eightonegulf/OpenController/Hardware/Main/Main.kicad_pcb

## KiCad design Hardware/Main/Main.kicad_pcb (2024-09-18)

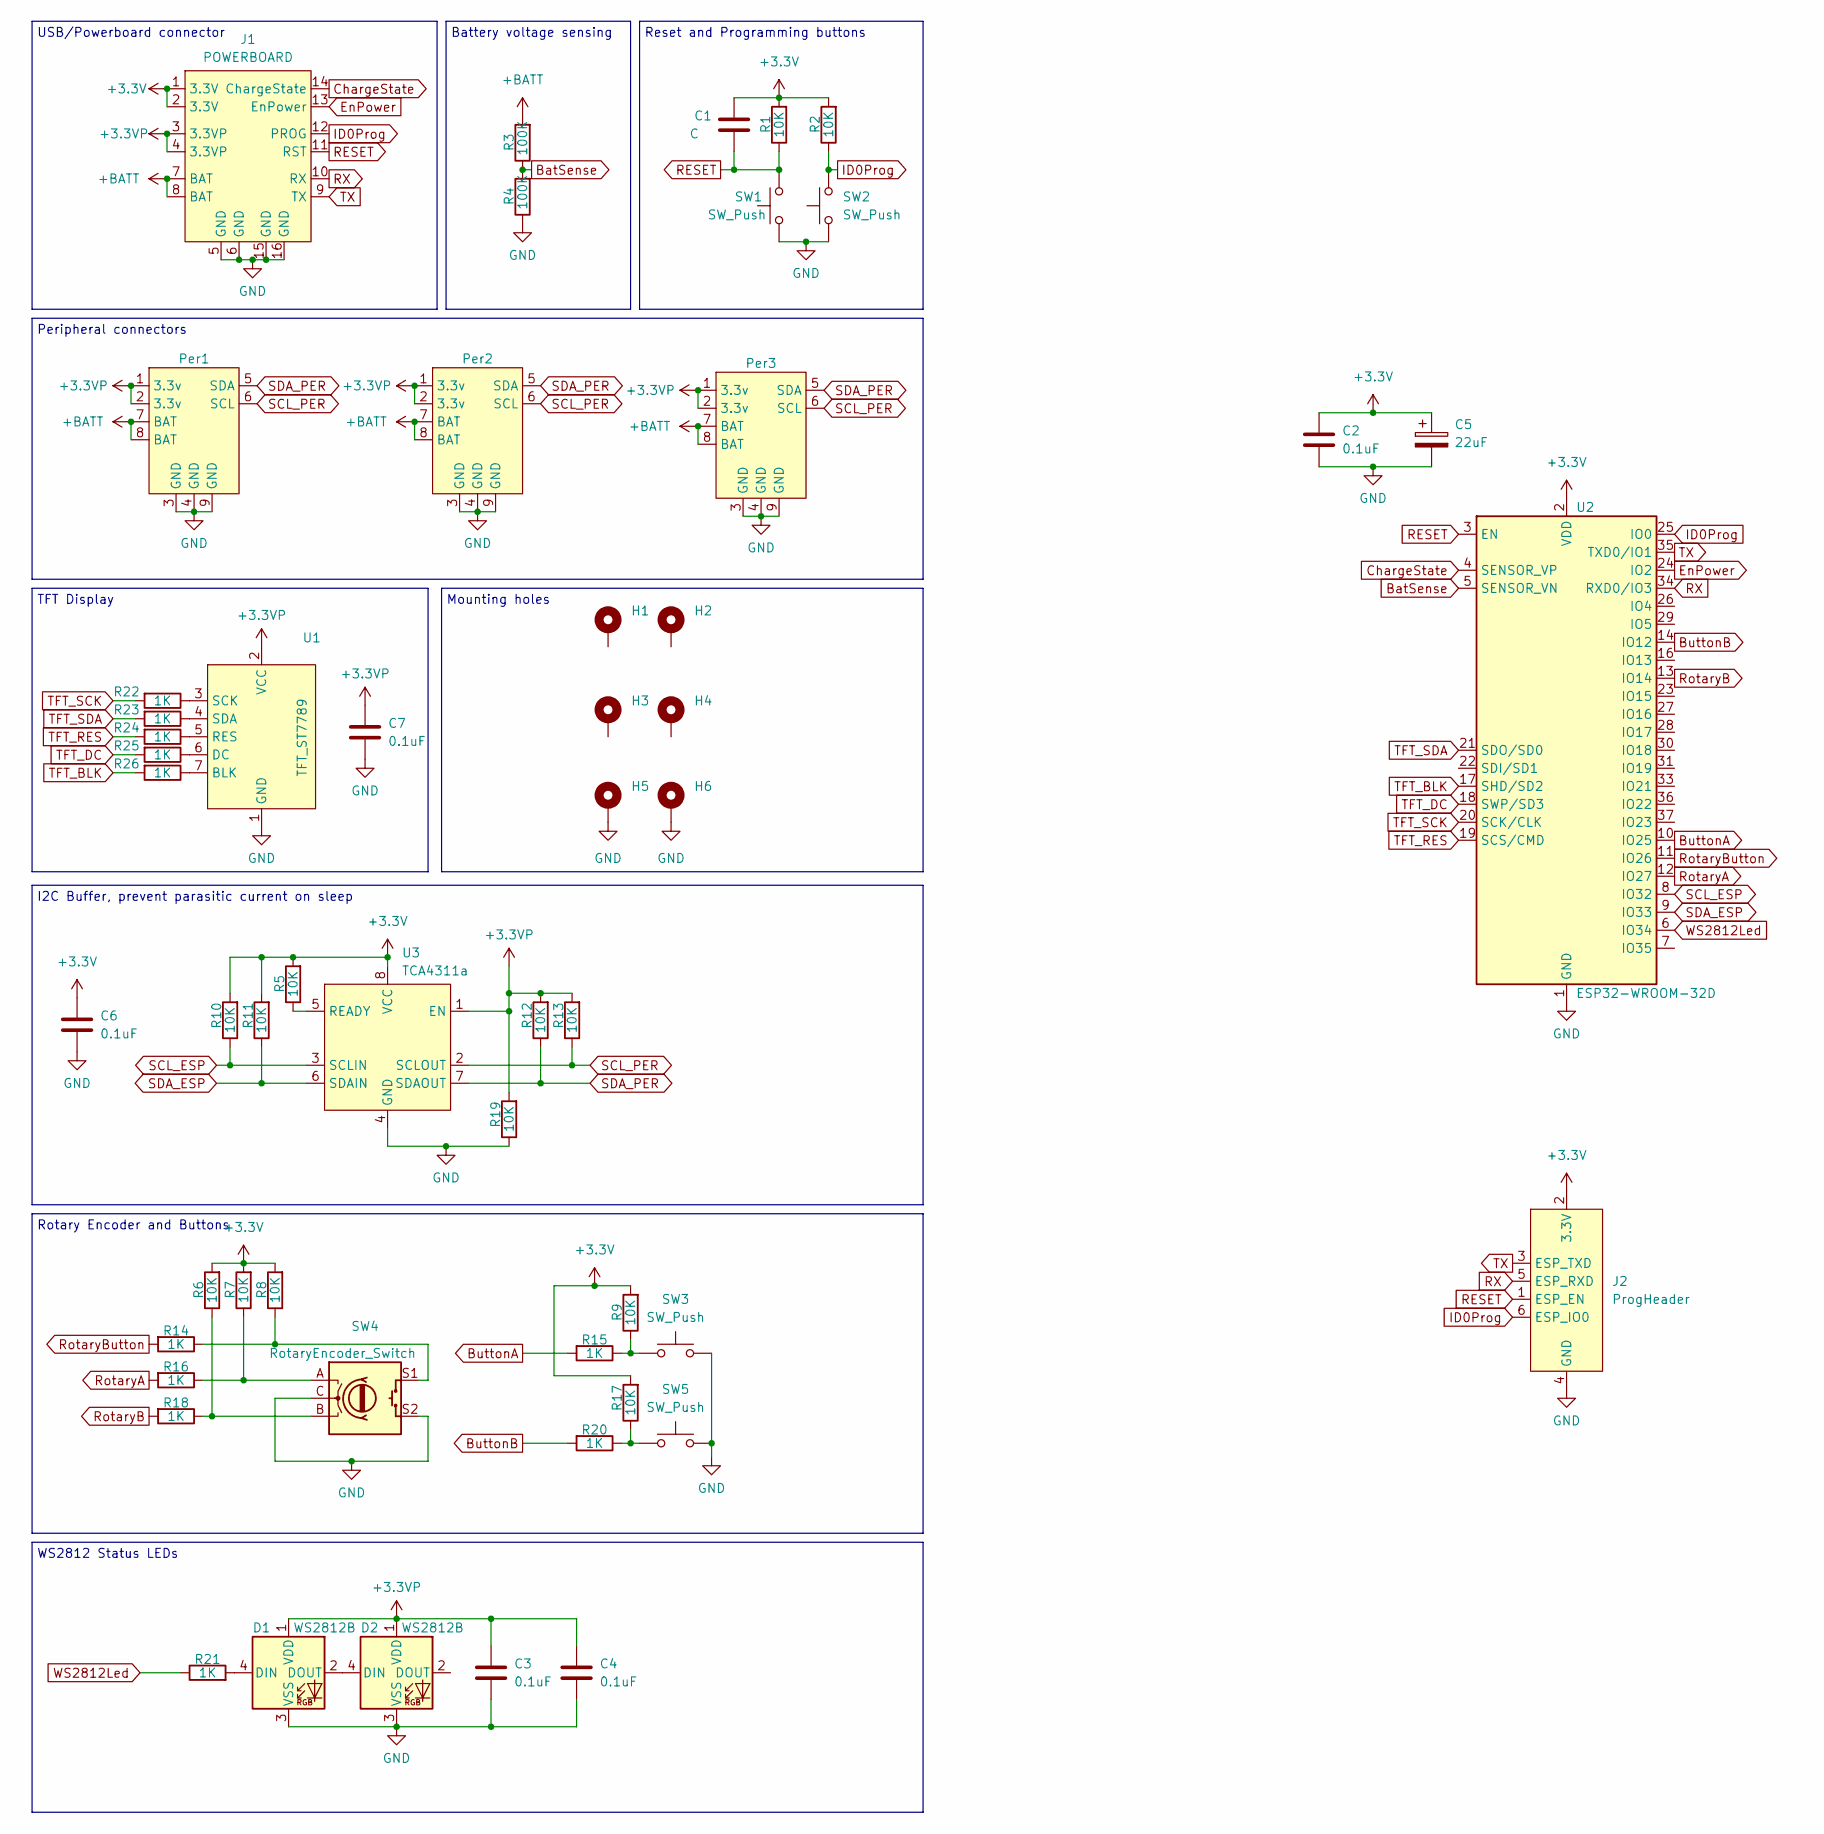
[picture p1: schematic Main.kicad_sch]

Parts:
C1: C; C_0805_2012Metric_Pad1.18x1.45mm_HandSolder
C2, C3, C4, C6, C7: 0.1uF; C_0805_2012Metric_Pad1.18x1.45mm_HandSolder
C5: 22uF; CP_Elec_4x5.3
D1, D2: WS2812B; LED_WS2812B_PLCC4_5.0x5.0mm_P3.2mm
H1, H2: MountingHole_Pad; MountingHole_2.2mm_M2_DIN965_Pad
H3, H4, H5, H6: MountingHole_Pad; MountingHole_3.2mm_M3_DIN965_Pad
J1: POWERBOARD; PowerBoardConsumer
J2: ProgHeader; ESP32ProgHeader
Per1: PeripheralMaster
Per2: PeripheralMaster_Right
Per3: PeripheralMaster_Left
R1, R2, R5, R6, R7, R8, R9, R10, R11, R12, R13, R17, R19: 10K; R_0805_2012Metric_Pad1.20x1.40mm_HandSolder
R3, R4: 100K; R_0805_2012Metric_Pad1.20x1.40mm_HandSolder
R14, R15, R16, R18, R20, R21, R22, R23, R24, R25, R26: 1K; R_0805_2012Metric_Pad1.20x1.40mm_HandSolder
SW1, SW2: SW_Push; SW_SPST_TL3305A
SW3, SW5: SW_Push; SW_PUSH_6mm_H8mm
SW4: RotaryEncoder_Switch; RotaryEncoder_Alps_EC11E-Switch_Vertical_H20mm
U1: TFT_ST7789; RGB_TFT_1.3
U2: ESP32-WROOM-32D
U3: TCA4311a; SOIC-8_3.9x4.9mm_P1.27mm

Connections:
+3.3V: C1.2, C2.1, C5.1, C6.1, J1.1 (3.3V), J1.2 (3.3V), J2.2 (3.3V), R1.2, R2.2, R5.2, R6.2, R7.2, R8.2, R9.2, R10.2, R11.2, R17.2, U2.2 (VDD), U3.8 (VCC)
+3.3VP: C3.1, C4.1, C7.1, D1.1 (VDD), D2.1 (VDD), J1.3 (3.3VP), J1.4 (3.3VP), Per1.1 (3.3v), Per1.2 (3.3v), Per2.1 (3.3v), Per2.2 (3.3v), Per3.1 (3.3v), Per3.2 (3.3v), R12.2, R13.2, R19.2, U1.2 (VCC), U3.1 (EN)
+BATT: J1.7 (BAT), J1.8 (BAT), Per1.7 (BAT), Per1.8 (BAT), Per2.7 (BAT), Per2.8 (BAT), Per3.7 (BAT), Per3.8 (BAT), R3.2
BatSense: R3.1, R4.2, U2.5 (SENSOR_VN)
ButtonA: R15.2, U2.10 (IO25)
ButtonB: R20.2, U2.14 (IO12)
ChargeState: J1.14 (ChargeState), U2.4 (SENSOR_VP)
EnPower: J1.13 (EnPower), U2.24 (IO2)
GND: C2.2, C3.2, C4.2, C5.2, C6.2, C7.2, D1.3 (VSS), D2.3 (VSS), H5.1, H6.1, J1.5 (GND), J1.6 (GND), J1.15 (GND), J1.16 (GND), J2.4 (GND), Per1.3 (GND), Per1.4 (GND), Per1.9 (GND), Per2.3 (GND), Per2.4 (GND), Per2.9 (GND), Per3.3 (GND), Per3.4 (GND), Per3.9 (GND), R4.1, R19.1, SW1.1, SW2.1, SW3.2, SW4.C, SW4.S2, SW5.2, U1.1 (GND), U2.1 (GND), U2.15 (GND), U2.38 (GND), U2.39 (GND), U3.4 (GND)
ID0Prog: J1.12 (PROG), J2.6 (ESP_IO0), R2.1, SW2.2, U2.25 (IO0)
unnamed: D1.4 (DIN), R21.2
unnamed: D1.2 (DOUT), D2.4 (DIN)
unnamed: R8.1, R14.1, SW4.S1
unnamed: R9.1, R15.1, SW3.1
unnamed: R7.1, R16.1, SW4.A
unnamed: R17.1, R20.1, SW5.1
unnamed: R6.1, R18.1, SW4.B
unnamed: R26.1, U1.7 (BLK)
unnamed: R25.1, U1.6 (DC)
unnamed: R24.1, U1.5 (RES)
unnamed: R22.1, U1.3 (SCK)
unnamed: R23.1, U1.4 (SDA)
unnamed: R5.1, U3.5 (READY)
RESET: C1.1, J1.11 (RST), J2.1 (ESP_EN), R1.1, SW1.2, U2.3 (EN)
RX: J1.10 (RX), J2.5 (ESP_RXD), U2.34 (RXD0/IO3)
RotaryA: R16.2, U2.12 (IO27)
RotaryB: R18.2, U2.13 (IO14)
RotaryButton: R14.2, U2.11 (IO26)
SCL_ESP: R10.1, U2.8 (IO32), U3.3 (SCLIN)
SCL_PER: Per1.6 (SCL), Per2.6 (SCL), Per3.6 (SCL), R13.1, U3.2 (SCLOUT)
SDA_ESP: R11.1, U2.9 (IO33), U3.6 (SDAIN)
SDA_PER: Per1.5 (SDA), Per2.5 (SDA), Per3.5 (SDA), R12.1, U3.7 (SDAOUT)
TFT_BLK: R26.2, U2.17 (SHD/SD2)
TFT_DC: R25.2, U2.18 (SWP/SD3)
TFT_RES: R24.2, U2.19 (SCS/CMD)
TFT_SCK: R22.2, U2.20 (SCK/CLK)
TFT_SDA: R23.2, U2.21 (SDO/SD0)
TX: J1.9 (TX), J2.3 (ESP_TXD), U2.35 (TXD0/IO1)
WS2812Led: R21.1, U2.6 (IO34)

Notes on the sheet:
Mounting holes
Peripheral connectors
Reset and Programming buttons
WS2812 Status LEDs
TFT Display
I2C Buffer, prevent parasitic current on sleep
USB/Powerboard connector
Rotary Encoder and Buttons
Battery voltage sensing

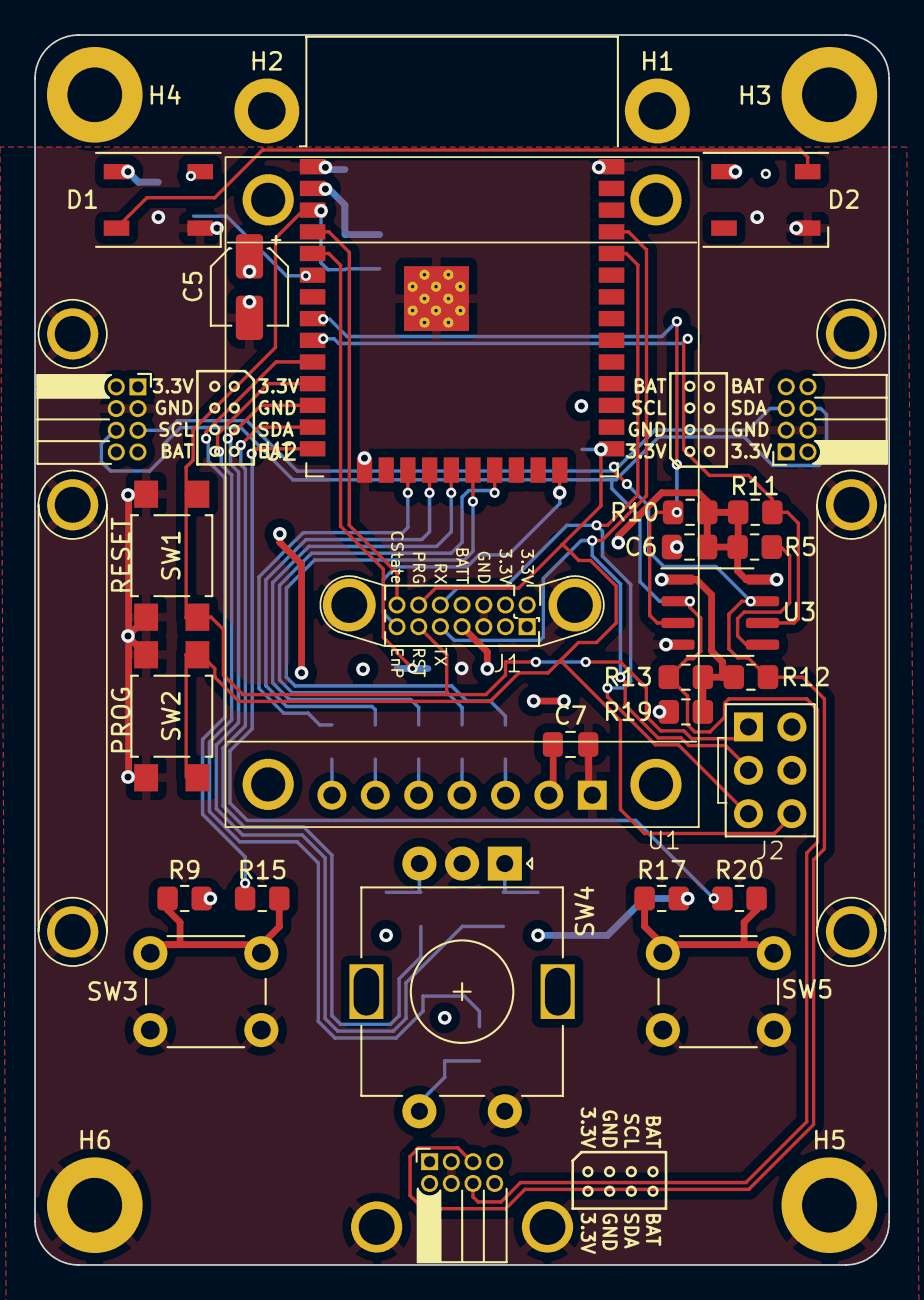
[picture p2: board Main.kicad_pcb from above]

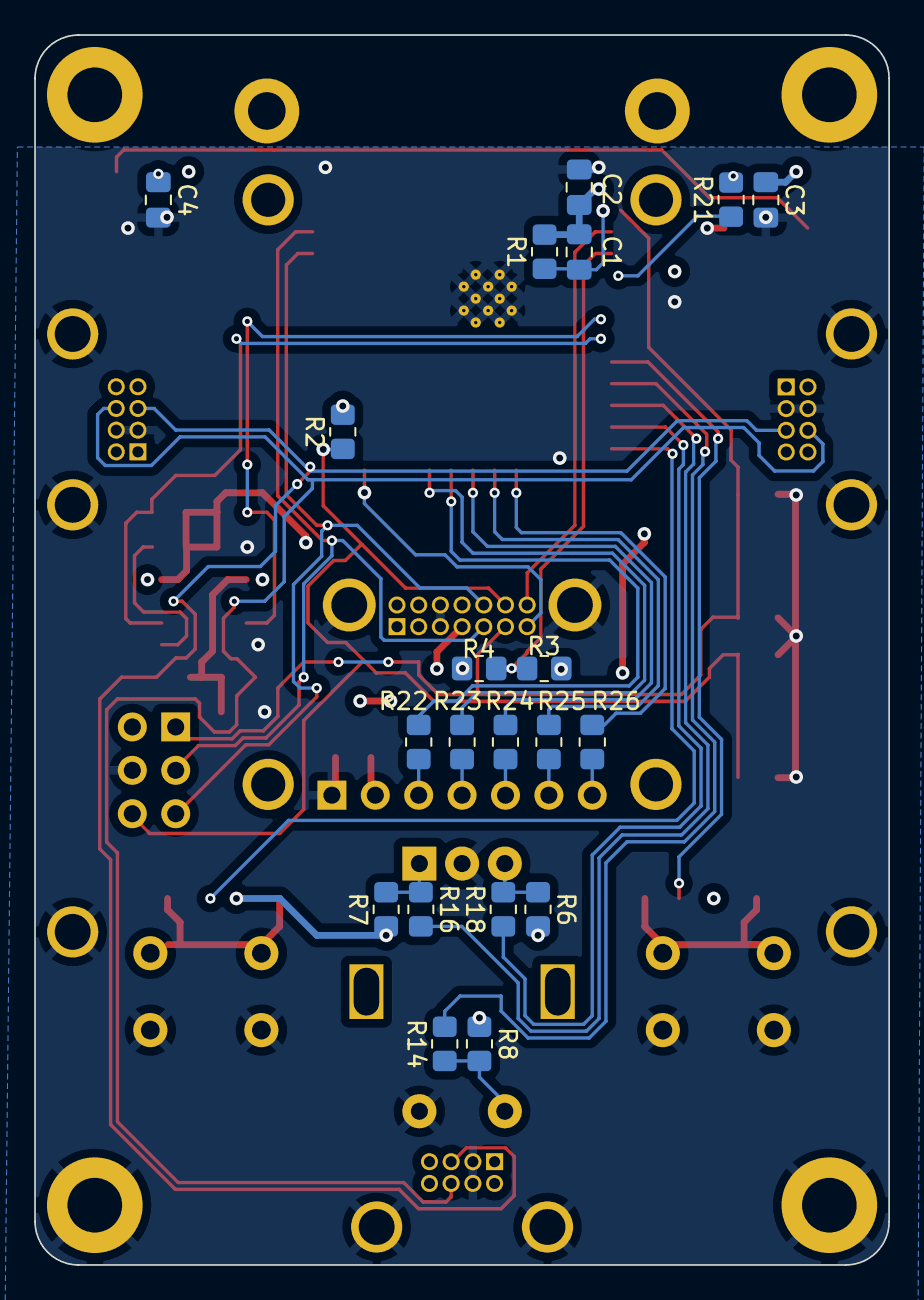
[picture p3: board Main.kicad_pcb from below]

Board: 4 copper layers, 50.0 x 72.0 mm, 54 parts (20 on the bottom side), 39 nets.
