eightonegulf/OpenController/Hardware/GamecontrollerPeripheral/GamecontrollerPeripheral.kicad_pcb

## KiCad design Hardware/GamecontrollerPeripheral/GamecontrollerPeripheral.kicad_pcb (2024-09-17)

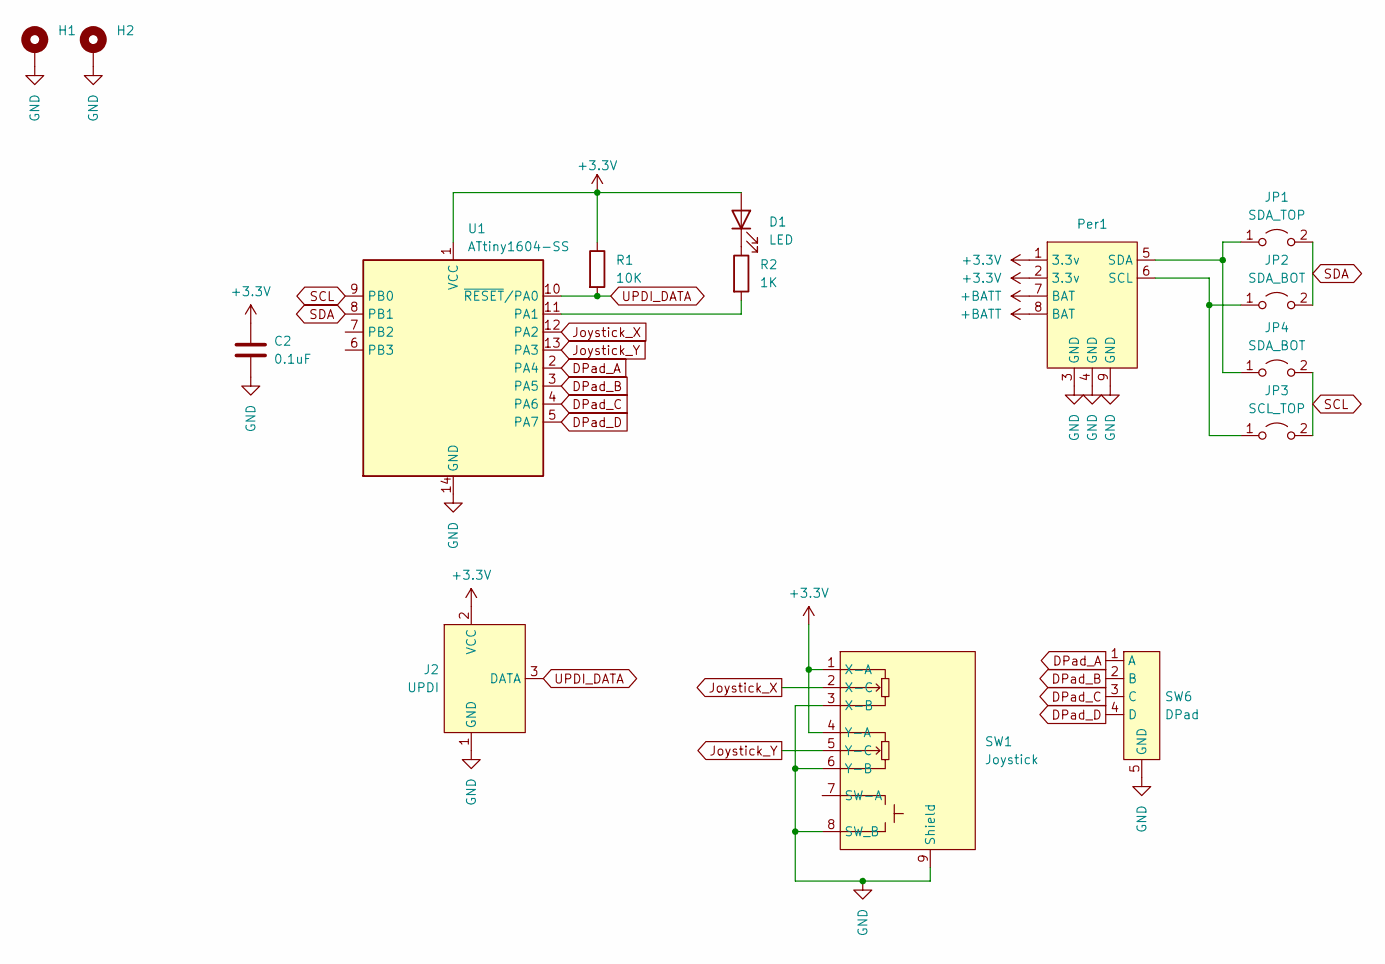
[picture p4: schematic GamecontrollerPeripheral.kicad_sch]

Parts:
C2: 0.1uF; C_0805_2012Metric_Pad1.18x1.45mm_HandSolder
D1: LED; LED_0805_2012Metric_Pad1.15x1.40mm_HandSolder
H1, H2: MountingHole_Pad; MountingHole_2.2mm_M2_DIN965_Pad
J2: UPDI; PinHeader_1x03_P2.54mm_Vertical
JP1: SDA_TOP; SolderJumper-2_P1.3mm_Open_RoundedPad1.0x1.5mm
JP2, JP4: SDA_BOT; SolderJumper-2_P1.3mm_Open_RoundedPad1.0x1.5mm
JP3: SCL_TOP; SolderJumper-2_P1.3mm_Open_RoundedPad1.0x1.5mm
Per1: PeripheralSlave
R1: 10K; R_0805_2012Metric_Pad1.20x1.40mm_HandSolder
R2: 1K; R_0805_2012Metric_Pad1.20x1.40mm_HandSolder
SW1: Joystick; Joystick-Universal
SW6: DPad; D-Pad
U1: ATtiny1604-SS; SOIC-14_3.9x8.7mm_P1.27mm

Connections:
+3.3V: D1.2 (A), J2.2 (VCC), Per1.1 (3.3v), Per1.2 (3.3v), R1.1, SW1.1 (X-A), SW1.4 (Y-A), U1.1 (VCC); also elsewhere on the board
+BATT: Per1.7 (BAT), Per1.8 (BAT)
DPad_A: SW6.1 (A), U1.2 (PA4)
DPad_B: SW6.2 (B), U1.3 (PA5)
DPad_C: SW6.3 (C), U1.4 (PA6)
DPad_D: SW6.4 (D), U1.5 (PA7)
GND: H1.1, H2.1, J2.1 (GND), Per1.3 (GND), Per1.4 (GND), Per1.9 (GND), SW1.3 (X-B), SW1.6 (Y-B), SW1.8 (SW_B), SW1.9 (Shield), SW6.5 (GND), U1.14 (GND); also elsewhere on the board
Joystick_X: SW1.2 (X-C), U1.12 (PA2)
Joystick_Y: SW1.5 (Y-C), U1.13 (PA3)
unnamed: D1.1 (K), R2.1
unnamed: JP1.1 (A), JP4.1 (A), Per1.5 (SDA)
unnamed: JP2.1 (A), JP3.1 (A), Per1.6 (SCL)
unnamed: R2.2, U1.11 (PA1)
SCL: JP3.2 (B), JP4.2 (B), U1.9 (PB0)
SDA: JP1.2 (B), JP2.2 (B), U1.8 (PB1)
UPDI_DATA: J2.3 (DATA), R1.2, U1.10 (~RESET/PA0)

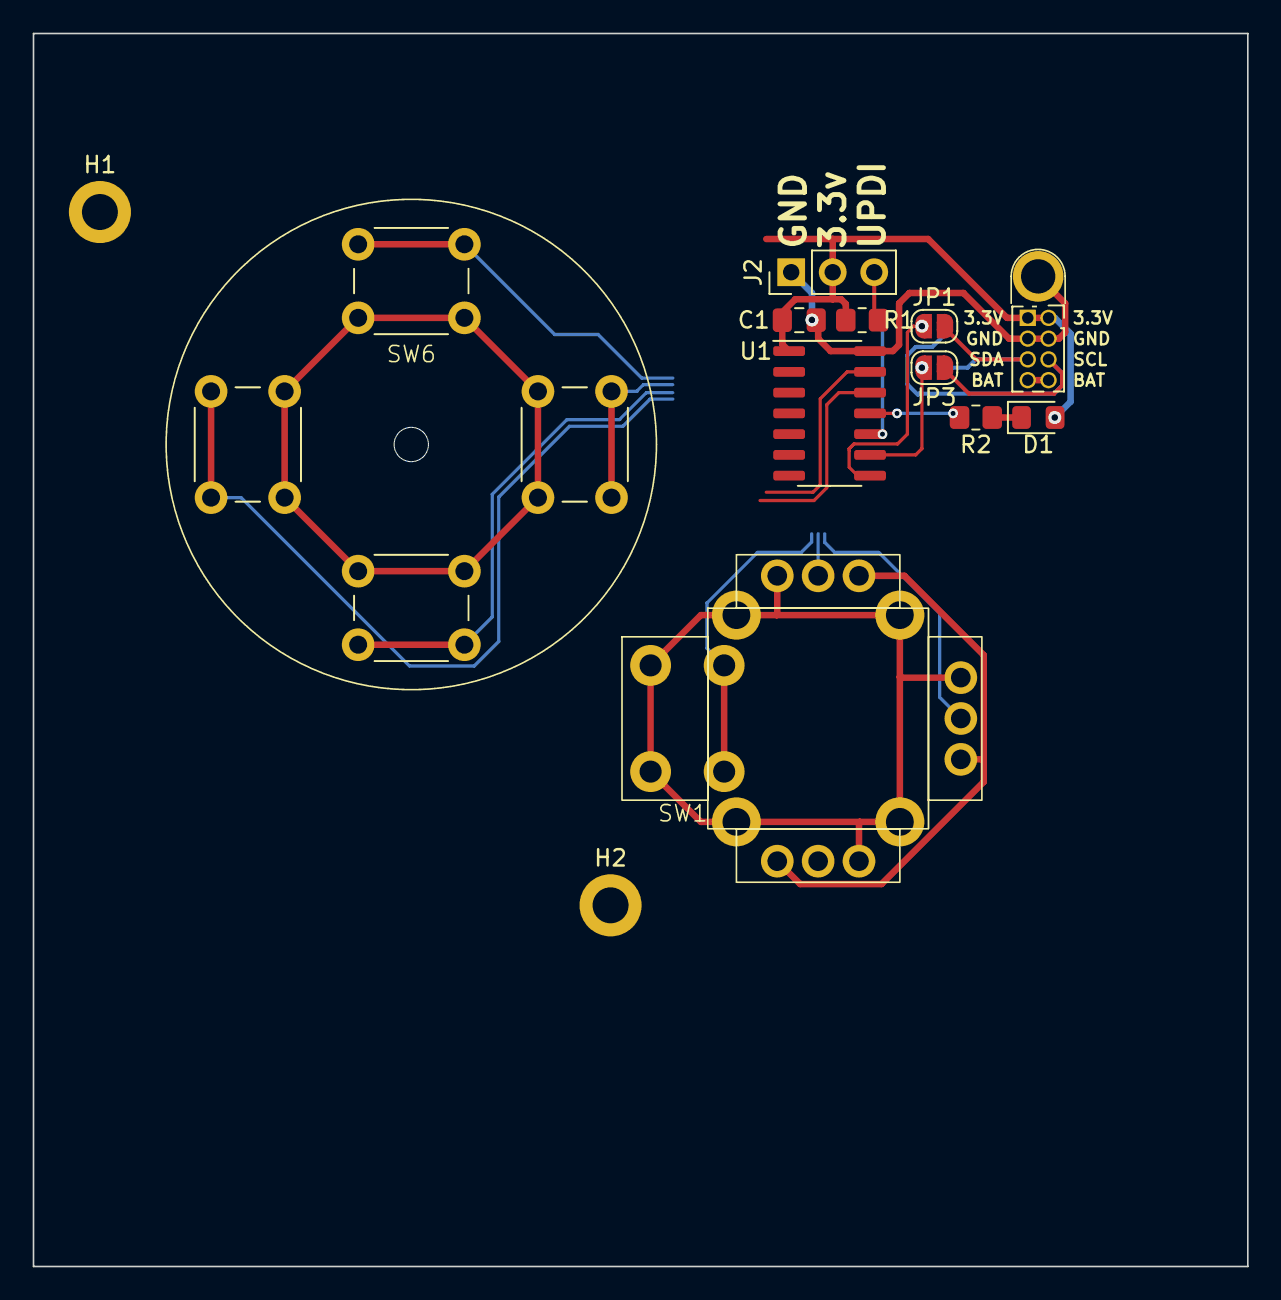
[picture p5: board GamecontrollerPeripheral.kicad_pcb from above]

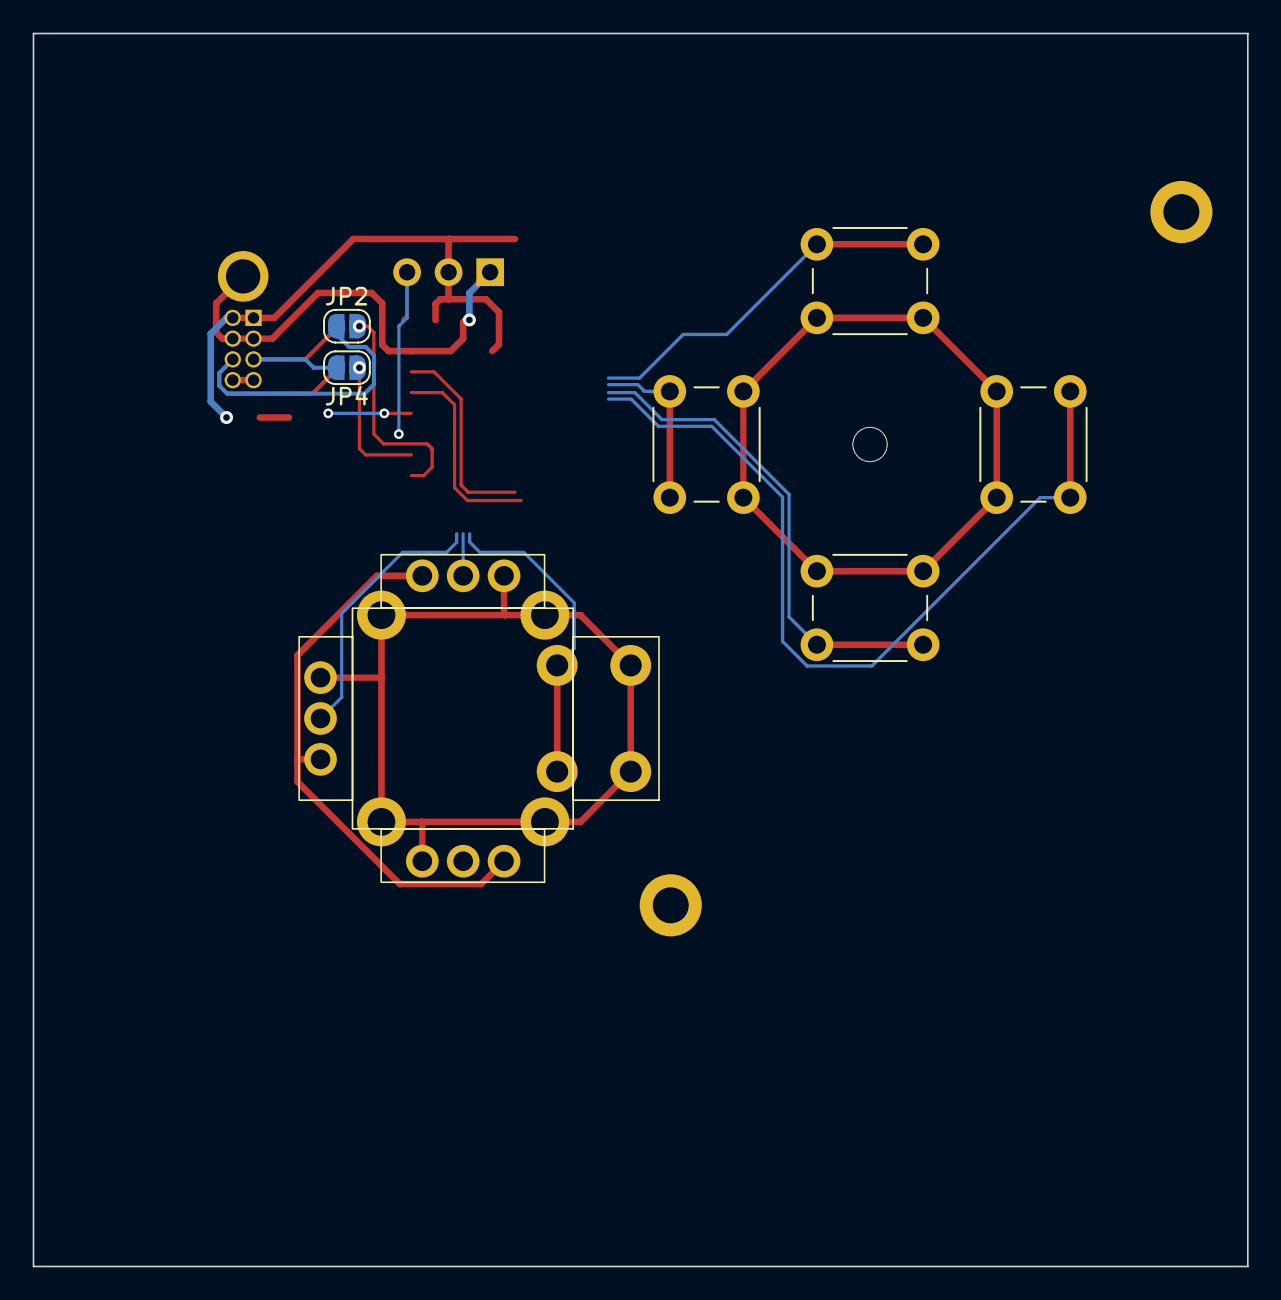
[picture p6: board GamecontrollerPeripheral.kicad_pcb from below]

Board: 2 copper layers, 74.3 x 75.4 mm, 15 parts (2 on the bottom side), 16 nets.

Other parts of the board:
C1: 0.1uF; C_0805_2012Metric_Pad1.18x1.45mm_HandSolder

Their connections:
+3.3V: C1.1; also elsewhere on the board
GND: C1.2; also elsewhere on the board
