eightonegulf/OpenController/Hardware/USBBoard/USBBoard.kicad_pcb

## KiCad design Hardware/USBBoard/USBBoard.kicad_pcb (2024-09-13)

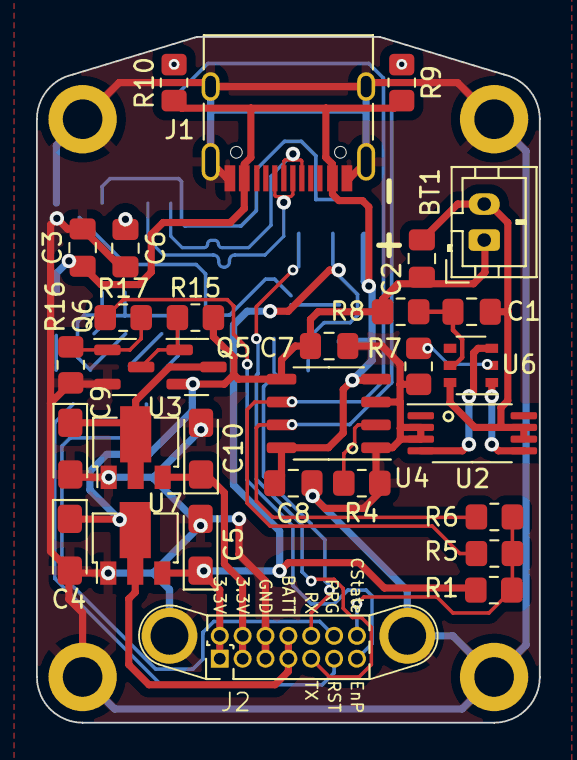
[picture p7: board USBBoard.kicad_pcb from above]

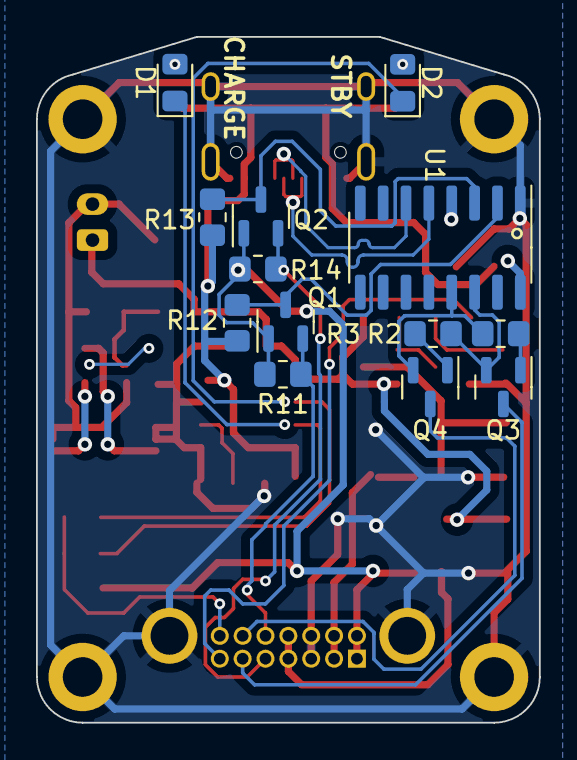
[picture p8: board USBBoard.kicad_pcb from below]

Board: 2 copper layers, 27.9 x 38.1 mm, 48 parts (13 on the bottom side), 33 nets.

Parts:
BT1: Battery_Cell; JST_PH_B2B-PH-K_1x02_P2.00mm_Vertical
C1: 100nF; C_0805_2012Metric_Pad1.18x1.45mm_HandSolder
C2, C7, C8: 10uF; C_0805_2012Metric_Pad1.18x1.45mm_HandSolder
C3, C6: 0.1uF; C_0805_2012Metric_Pad1.18x1.45mm_HandSolder
C4, C5, C9, C10: 1uF Tantalum; CP_EIA-3216-18_Kemet-A_Pad1.58x1.35mm_HandSolder
D1: CHARGE; D_0805_2012Metric_Pad1.15x1.40mm_HandSolder
D2: STBY; D_0805_2012Metric_Pad1.15x1.40mm_HandSolder
H1, H2, H3, H4: MountingHole_Pad; MountingHole_2.2mm_M2_DIN965_Pad
J1: USB_C_Receptacle_USB2.0; USB_C_Receptacle_HRO_TYPE-C-31-M-12
J2: POWERBOARD; PowerBoard
Q1, Q2: BS170F; SOT-23
Q3, Q4: BC846; SOT-23
Q5: AO3401A; SOT-23
Q6: 2N7002; SOT-23
R1, R5: 50K; R_0805_2012Metric_Pad1.20x1.40mm_HandSolder
R2, R3, R11, R12, R13, R14: 12K; R_0805_2012Metric_Pad1.20x1.40mm_HandSolder
R4: R; R_0805_2012Metric_Pad1.20x1.40mm_HandSolder
R6: 25K; R_0805_2012Metric_Pad1.20x1.40mm_HandSolder
R7, R9, R10, R17: 1K; R_0805_2012Metric_Pad1.20x1.40mm_HandSolder
R8: 100; R_0805_2012Metric_Pad1.20x1.40mm_HandSolder
R15, R16: 10K; R_0805_2012Metric_Pad1.20x1.40mm_HandSolder
U1: CH340C; SOIC-16_3.9x9.9mm_P1.27mm
U2: FS8205A; TSSOP-8_4.4x3mm_P0.65mm
U3, U7: XC6203; SOT-89-3
U4: TC4056A; SOP-8_3.9x4.9mm_P1.27mm
U6: DW01-P; TSOP-6_1.65x3.05mm_P0.95mm

Connections:
+3.3V: C5.1, J2.1 (3.3V), J2.2 (3.3V), Q1.1 (G), Q2.1 (G), R1.2, R11.2, R14.2, U7.3 (VOUT)
+3.3VP: C10.1, J2.3 (3.3VP), J2.4 (3.3VP), U3.3 (VOUT)
+5V: C3.1, C8.2, J1.A4 (VBUS), J1.A9 (VBUS), J1.B4 (VBUS), J1.B9 (VBUS), R9.2, R10.2, R12.2, R13.2, U1.16 (VCC), U4.4 (VCC), U4.8 (CE)
+BATT: BT1.1 (+), C2.1, C4.1, C7.1, J2.7 (BAT), J2.8 (BAT), Q5.2 (S), R8.1, R15.2, U4.5 (BAT), U7.2 (VIN)
-BATT: BT1.2 (-), C1.2, C2.2, U2.6 (S2), U2.7 (S2), U6.6 (GND)
ChargeState: J2.14 (ChargeState), R1.1, R5.2, R6.2
EnPower: J2.13 (EnPower), R17.2
GND: C3.2, C4.2, C5.2, C6.2, C7.2, C8.1, C9.2, C10.2, H1.1, H2.1, H3.1, H4.1, J1.A1 (GND), J1.A12 (GND), J1.B1 (GND), J1.B12 (GND), J1.S1 (SHIELD), J2.5 (GND), J2.6 (GND), J2.15 (GND), J2.16 (GND), Q6.2 (S), R4.2, R7.1, R16.1, U1.1 (GND), U2.2 (S1), U2.3 (S1), U3.1 (GND), U4.1 (TEMP), U4.3 (GND), U7.1 (GND)
unnamed: D1.2 (A), R9.1
unnamed: D2.2 (A), R10.1
unnamed: Q1.3 (D), R12.1, U1.2 (TXD)
unnamed: Q2.3 (D), R13.1, U1.3 (RXD)
unnamed: Q3.1 (B), R2.2
unnamed: Q3.2 (E), R3.1, U1.14 (~RTS)
unnamed: Q4.1 (B), R3.2
unnamed: Q4.2 (E), R2.1, U1.13 (~DTR)
unnamed: C9.1, Q5.3 (D), U3.2 (VIN)
unnamed: Q5.1 (G), Q6.3 (D), R15.1
unnamed: Q6.1 (G), R16.2, R17.1
unnamed: C6.1, U1.4 (V3)
unnamed: U2.4 (G1), U6.3 (OC)
unnamed: U2.5 (G2), U6.1 (OD)
unnamed: R4.1, U4.2 (PROG)
unnamed: R7.2, U6.2 (CS)
unnamed: C1.1, R8.2, U6.5 (VCC)
STATE_CHARGE: D1.1 (K), R6.1, U4.7 (CHARGE)
STATE_STBY: D2.1 (K), R5.1, U4.6 (STBY)
UC_EN: J2.11 (RST), Q3.3 (C)
UC_ID0: J2.12 (PROG), Q4.3 (C)
UC_RX: J2.10 (RX), Q1.2 (S), R11.1
UC_TX: J2.9 (TX), Q2.2 (S), R14.1
USB_D+: J1.A6 (D+), J1.B6 (D+), U1.5 (UD+)
USB_D-: J1.A7 (D-), J1.B7 (D-), U1.6 (UD-)
