eightonegulf/OpenController/(commit log)

2024-09-11 Initial design in progress
    [Main.kicad_pcb, Main.kicad_sch, USBBoard.kicad_pcb, USBBoard.kicad_sch]
2024-09-11 Fix grouping issue on USBBoard
    [USBBoard.kicad_pcb]
2024-09-11 UPDI Connector
2024-09-12 GamecontrollerPeripheral progres
    [GamecontrollerPeripheral.kicad_pcb, GamecontrollerPeripheral.kicad_sch]
2024-09-12 USBBoard complete
    [USBBoard.kicad_pcb, USBBoard.kicad_sch]
2024-09-12 Library paths relative instead of absolute
    [Main.kicad_pcb, USBBoard.kicad_pcb, USBBoard.kicad_sch]
2024-09-12 Mainboard edge cuts
    [Main.kicad_pcb]
2024-09-13 USBBoard tweaks
    [USBBoard.kicad_pcb]
2024-09-13 Mainboard routing etc
    [Main.kicad_pcb, Main.kicad_sch]
2024-09-13 3D Models initial
    [Common.scad, Connectors.scad, GamecontrollerPeripheral.scad, InputDevices.scad, MainBoard.scad, USBBoard.scad]
2024-09-13 2.56 header and socket models
    [Connectors.scad]
2024-09-13 TFT display model
    [OutputDevices.scad]
2024-09-13 Use TFT display in mainboard model
    [MainBoard.scad]
2024-09-13 DPad model
    [GamecontrollerPeripheral.scad, InputDevices.scad]
2024-09-15 ESP32 programming header component
2024-09-15 Progress with main board
    [Main.kicad_pcb, Main.kicad_sch]
2024-09-15 Fix Powerboard connectors courtyard
2024-09-15 Mainboard r0.1
    [Main.kicad_pcb, Main.kicad_sch]
2024-09-17 Need to make more commits; Changed design to use horizontal peripheral connectors. Changed models, more compact design. Still in progress
    [Case.scad, Connectors.scad, GamecontrollerPeripheral.kicad_pcb, InputDevices.scad, Main.kicad_pcb, Main.kicad_sch, MainBoard.scad, OutputDevices.scad]
2024-09-17 Some margins. Support for buttons and rotary encoder
    [Case.scad]
2024-09-17 Button springs
    [Case.scad, Common.scad]
2024-09-18 Apply Button springs
    [Case.scad]
2024-09-18 Sink main PCB into case
    [Case.scad]
2024-09-18 Case midpart walls, join with top
    [Case.scad]
2024-09-18 Exploded view
    [Case.scad]
2024-09-18 USB port to case
    [Case.scad, USBBoard.scad]
2024-09-18 Rounded case edges
    [Case.scad, Common.scad]
2024-09-18 Better resolution on bolt holes Bottom peripheral cutout
    [Case.scad]
2024-09-18 Peripheral cutout trimming
    [Case.scad]
2024-09-18 Button indent
    [Case.scad]
2024-09-18 Cleanup output
    [Case.scad]
2024-09-18 Smaller mainboard pillars
    [Case.scad]
2024-09-18 PCBBoard connector to other side of board
    [Main.kicad_pcb]
2024-09-18 Add extra mountingscrew to side peripherals
    [Case.scad, Connectors.scad, Main.kicad_pcb, Main.kicad_sch]
